polothil/sumo-robot/comb 1.stl

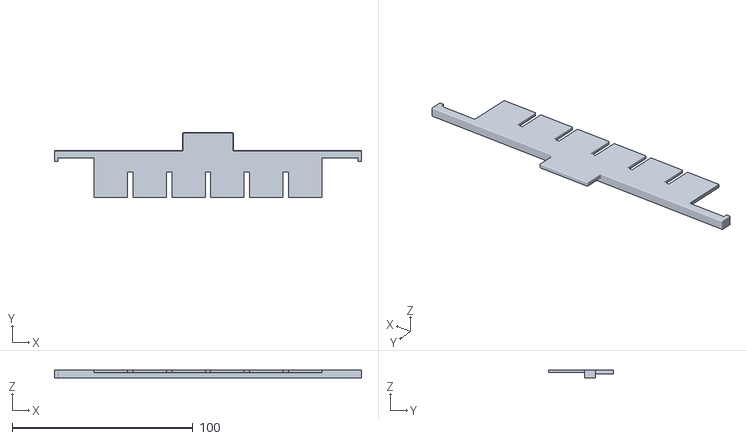
[picture p1: CAD file, 2022-11-23]
comb 1.stl
170.0 x 36.0 x 4.50
