polothil/sumo-robot/comb 2.stl

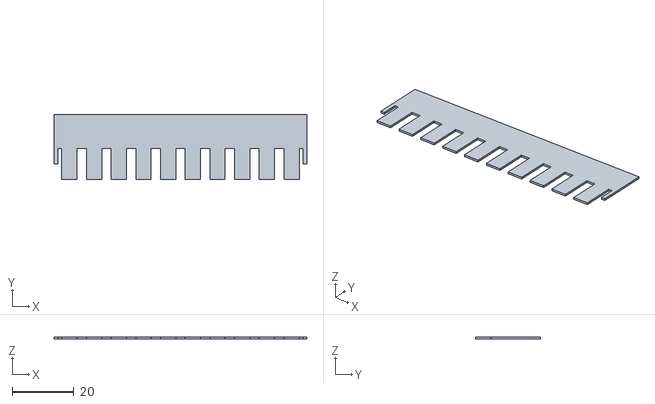
[picture p2: CAD file, 2022-11-23]
comb 2.stl
82.0 x 21.0 x 0.6
