polothil/sumo-robot/Översida.3mf

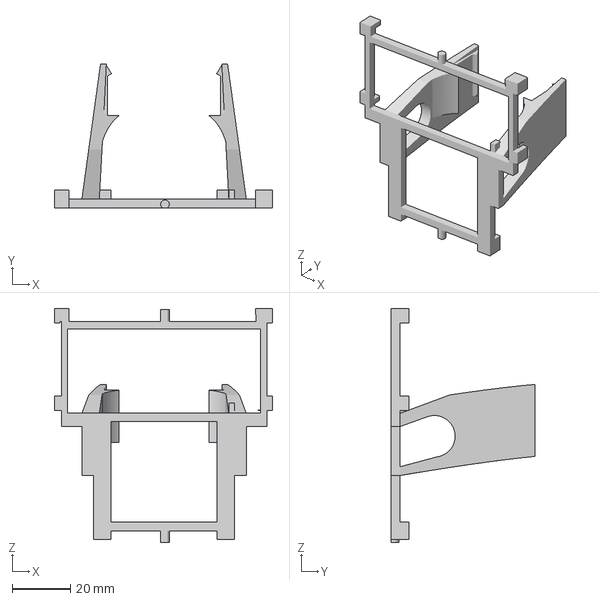
[picture p3: CAD file, 2022-11-20]
Översida.3mf
75.0 x 49.4 x 80.4 mm
