polothil/sumo-robot/side2.stl

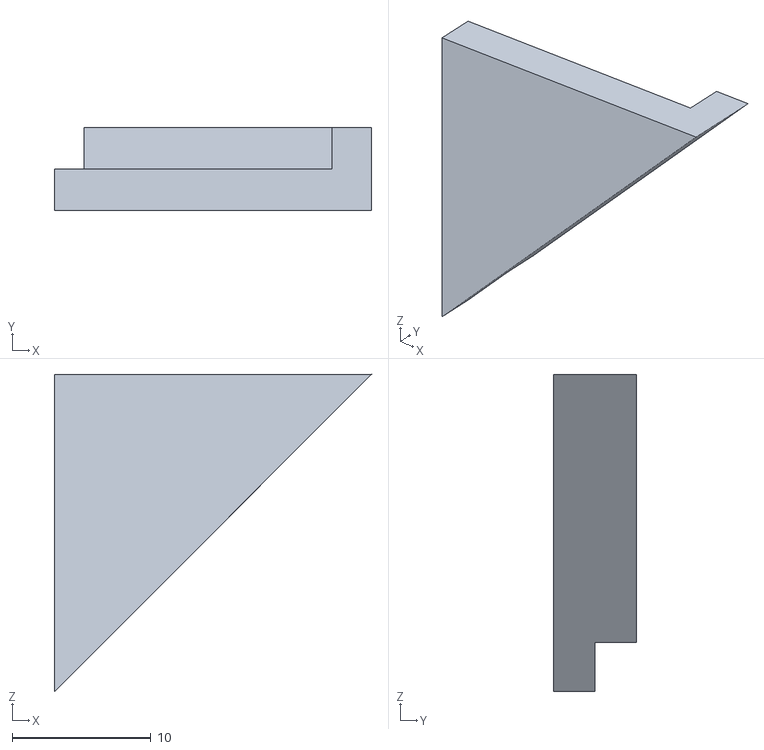
[picture p4: CAD file, 2022-11-20]
side2.stl
22.8 x 6.00 x 22.8
