polothil/sumo-robot/base support.stl

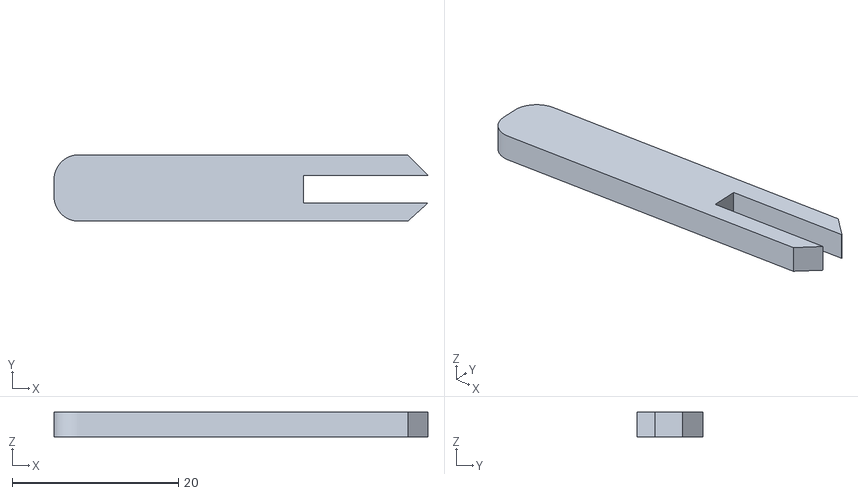
[picture p5: CAD file, 2022-11-20]
base support.stl
45.0 x 8.00 x 3.00
