polothil/sumo-robot/Undersida.3mf

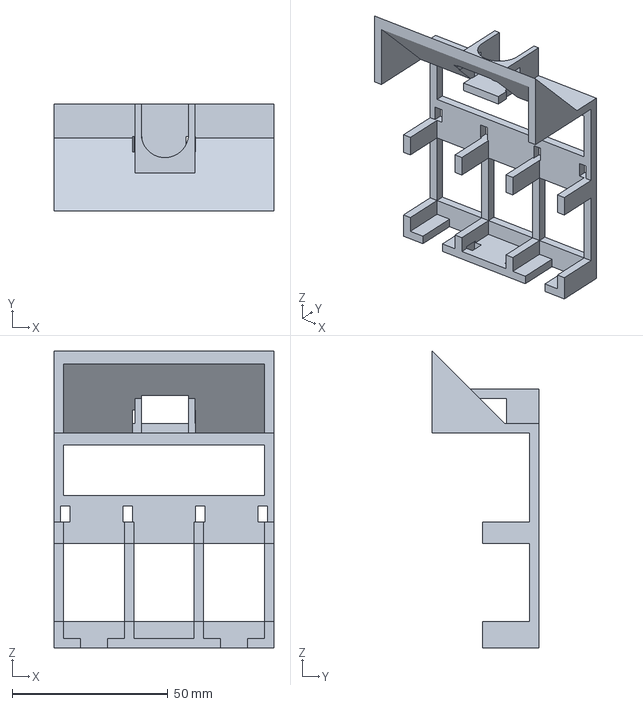
[picture p6: CAD file, 2022-11-20]
Undersida.3mf
70.6 x 34.2 x 95.3 mm
