polothil/sumo-robot/(list of files, cad)

Other CAD files:
side1.stl
