polothil/sumo-robot/Arduino codes/Ultrasonic basic/Ultrasonic basic.ino

/*
  HC-SR04 Basic Demonstration
  HC-SR04-Basic-Demo.ino
  Demonstrates functions of HC-SR04 Ultrasonic Range Finder
  Displays results on Serial Monitor
 
  DroneBot Workshop 2017
  http://dronebotworkshop.com
*/
 
// This uses Serial Monitor to display Range Finder distance readings
 
// Hook up HC-SR04 with Trig to Arduino Pin 10, Echo to Arduino pin 13
 
#define trigPin 10
#define echoPin 9
 
float duration, distance;
 
void setup() {
  Serial.begin (9600);
  pinMode(trigPin, OUTPUT);
  pinMode(echoPin, INPUT);
}
 
void loop() {
   
  // Write a pulse to the HC-SR04 Trigger Pin
  
  digitalWrite(trigPin, LOW);
  delayMicroseconds(2);
  digitalWrite(trigPin, HIGH);
  delayMicroseconds(10);
  digitalWrite(trigPin, LOW);
  
  // Measure the response from the HC-SR04 Echo Pin
 
  duration = pulseIn(echoPin, HIGH);
  
  // Determine distance from duration
  // Use 343 metres per second as speed of sound
  
  distance = (duration / 2) * 0.0343;
  
  // Send results to Serial Monitor
 
  Serial.print("Distance = ");
  if (distance >= 400 || distance <= 2) {
     Serial.println("Out of range");
  }
  else {
    Serial.print(distance);
    Serial.println(" cm");
    delay(500);
  }
  delay(500);
}
